TheArled/TheArled-s-KiCad-Library/3d_models/SLVS/Reference/251-Primo-EM158-6-mm-Omni-Electret-Capsules.png

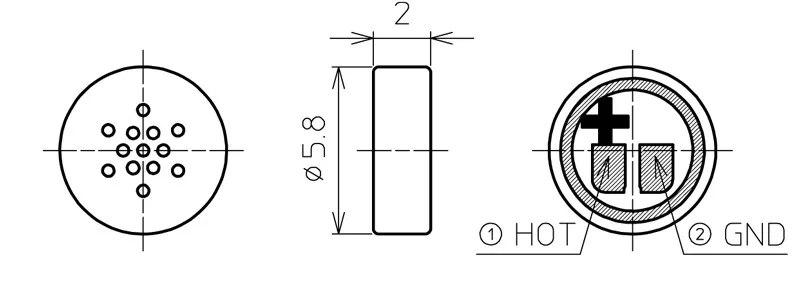
3d_models/SLVS/Reference/251-Primo-EM158-6-mm-Omni-Electret-Capsules.png
