TheArled/TheArled-s-KiCad-Library/3d_models/F305-1A7H1-21024-E100.step

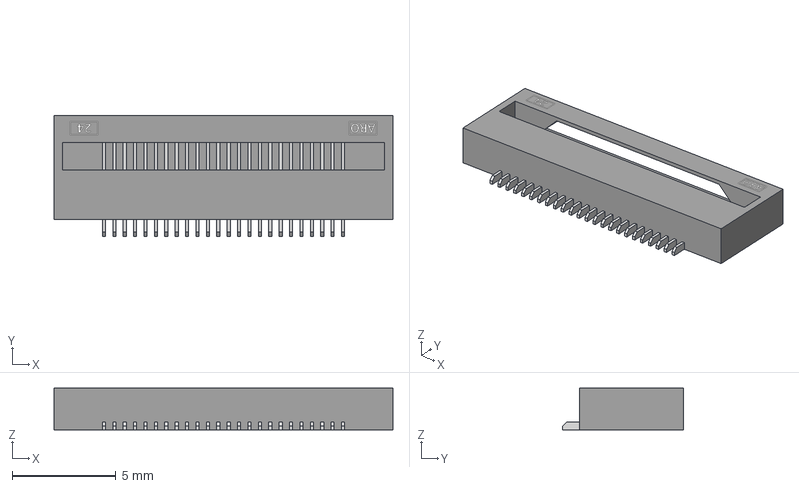
[picture p2: CAD file, 2025-11-04]
3d_models/F305-1A7H1-21024-E100.step
16.3 x 5.80 x 2.00 mm
