TheArled/TheArled-s-KiCad-Library/3d_models/MEM2075-00-140-01-A.step

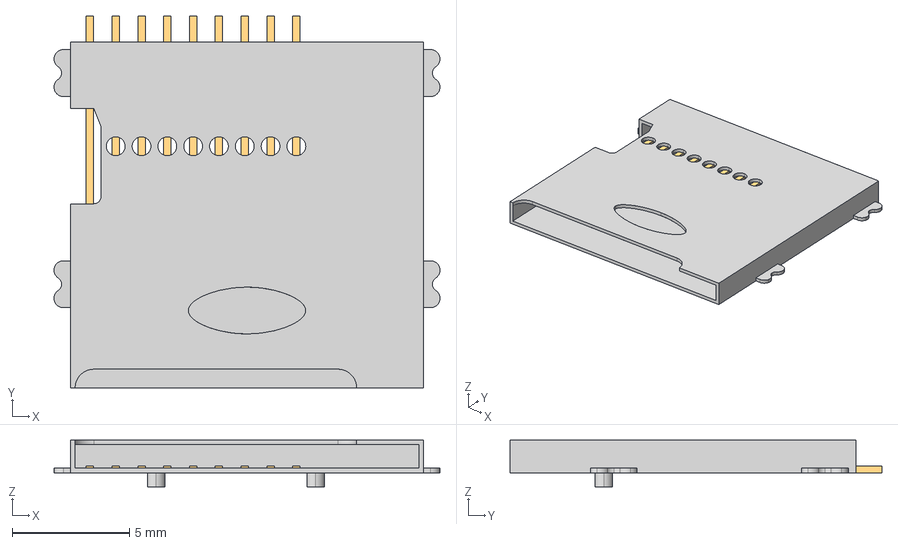
[picture p3: CAD file, 2025-11-04]
3d_models/MEM2075-00-140-01-A.step
16.4 x 15.8 x 2.00 mm
