TheArled/TheArled-s-KiCad-Library/3d_models/PEC16-2120F-S0012.step

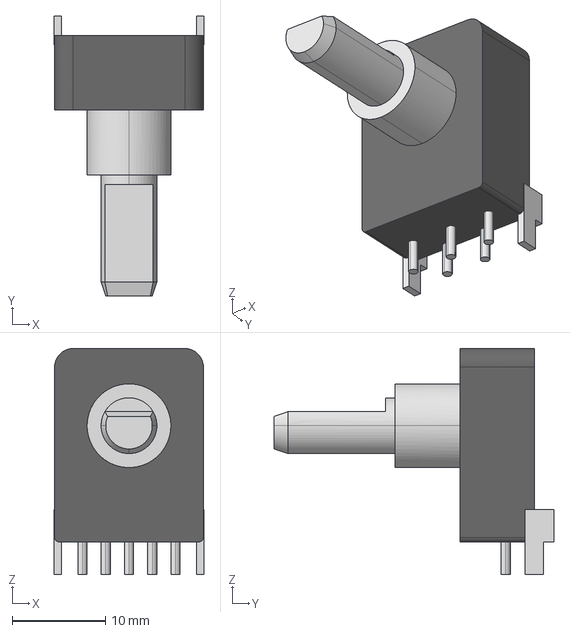
[picture p4: CAD file, 2025-11-04]
3d_models/PEC16-2120F-S0012.step
16.1 x 30.1 x 24.3 mm
