TheArled/TheArled-s-KiCad-Library/3d_models/A11AH.step

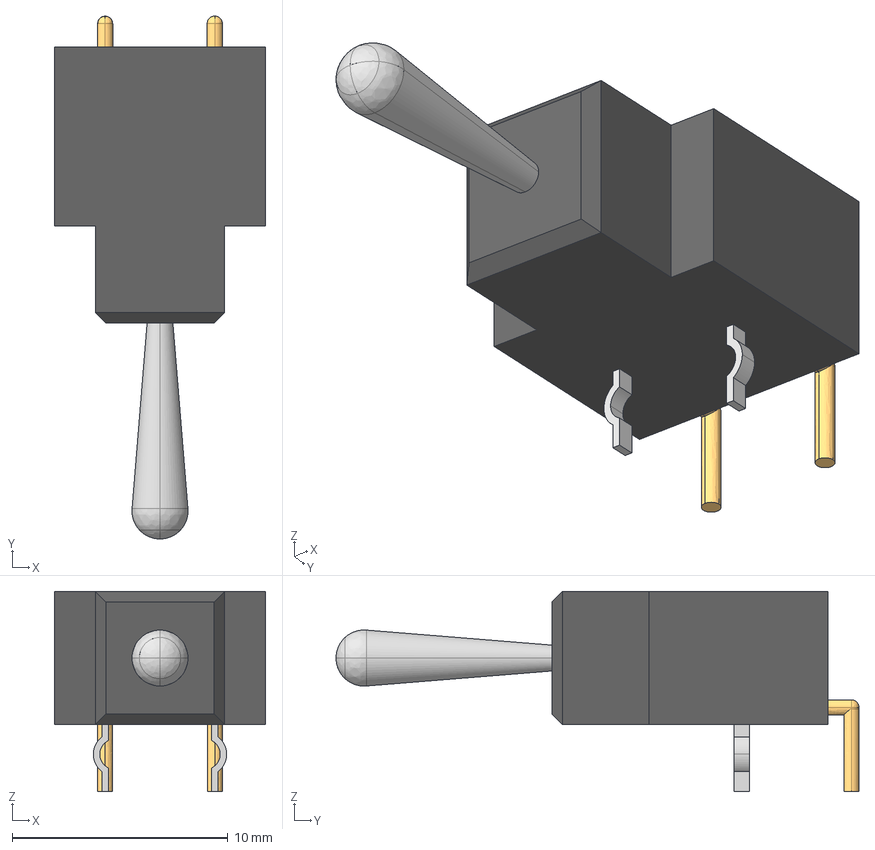
[picture p5: CAD file, 2025-11-03]
3d_models/A11AH.step
9.80 x 24.2 x 9.28 mm
