TheArled/TheArled-s-KiCad-Library/3d_models/53TR.step

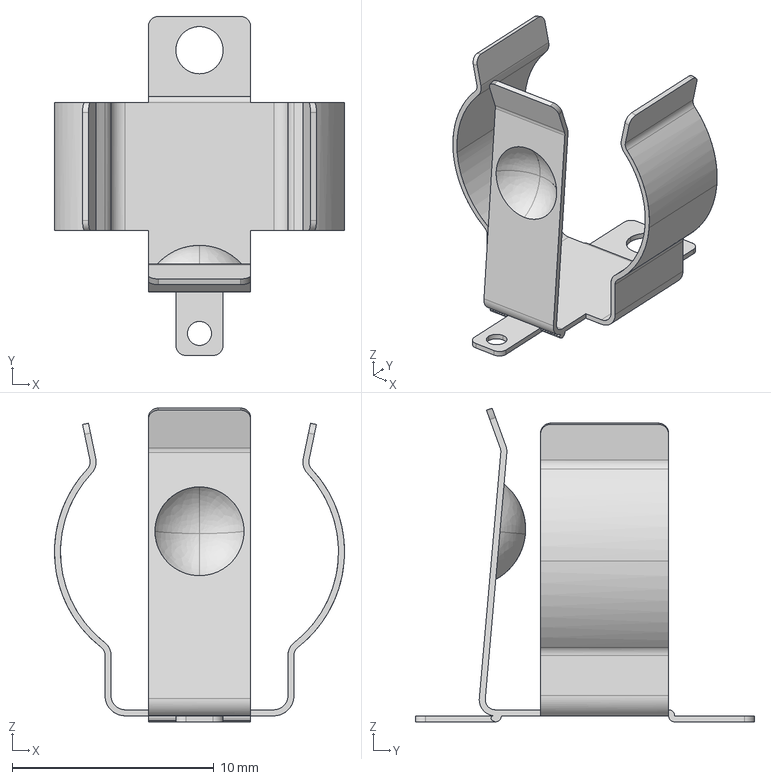
[picture p6: CAD file, 2025-10-24]
3d_models/53TR.step
14.4 x 16.8 x 15.6 mm
