TheArled/TheArled-s-KiCad-Library/3d_models/EM258.step

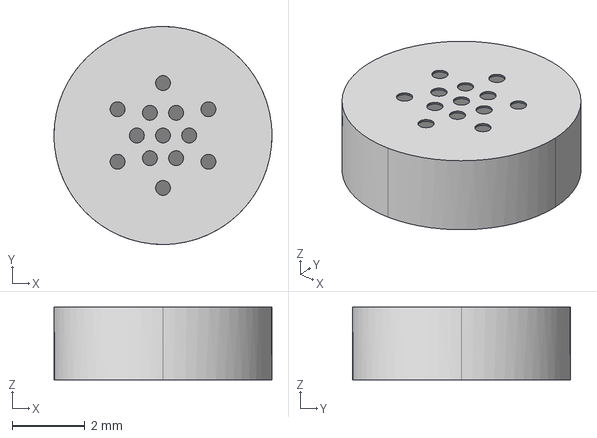
[picture p7: CAD file, 2025-10-20]
3d_models/EM258.step
6.00 x 6.00 x 2.00 mm
