TheArled/TheArled-s-KiCad-Library/3d_models/LTC3113EDHD#PBF.step

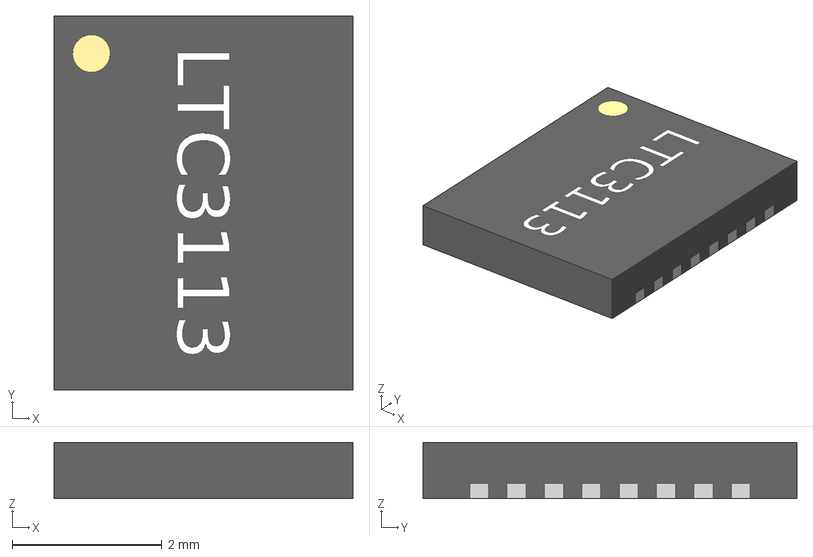
[picture p8: CAD file, 2025-09-15]
3d_models/LTC3113EDHD#PBF.step
4.00 x 5.00 x 0.75 mm
