TheArled/TheArled-s-KiCad-Library/3d_models/GRM188Z71A475ME15D.step

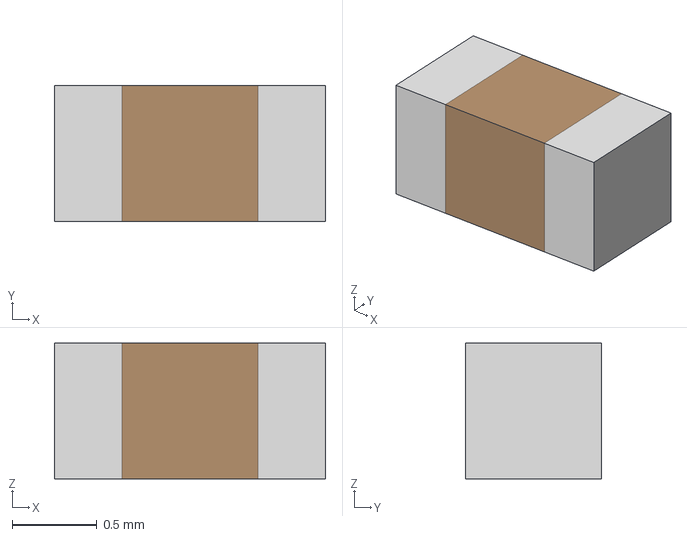
[picture p9: CAD file, 2025-09-12]
3d_models/GRM188Z71A475ME15D.step
1.60 x 0.8 x 0.8 mm
