TheArled/TheArled-s-KiCad-Library/3d_models/CX3225SA25000H0GSSC1.step

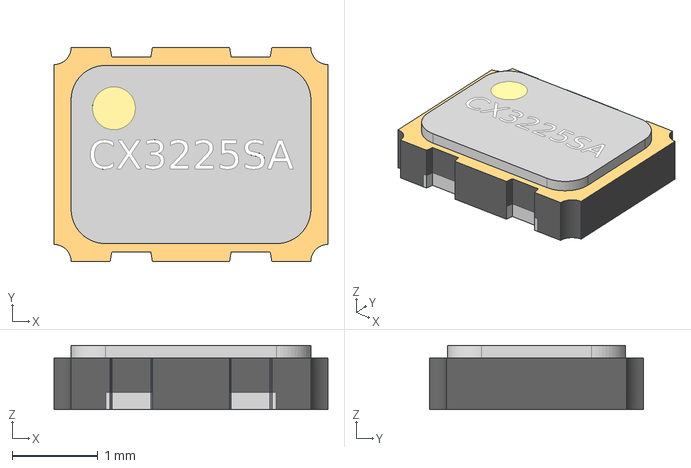
[picture p10: CAD file, 2025-09-12]
3d_models/CX3225SA25000H0GSSC1.step
3.20 x 2.50 x 0.75 mm
