TheArled/TheArled-s-KiCad-Library/3d_models/CDCE6214RGER.step

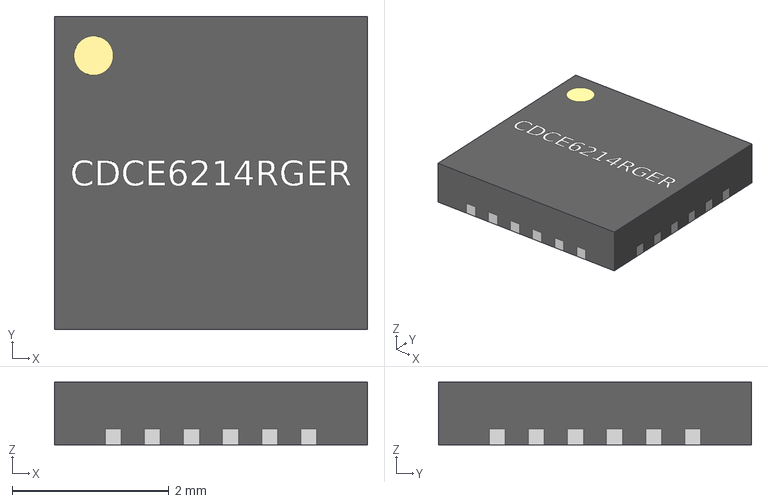
[picture p11: CAD file, 2025-09-12]
3d_models/CDCE6214RGER.step
4.00 x 4.00 x 0.8 mm
