TheArled/TheArled-s-KiCad-Library/3d_models/TPS7A2033PYCJR.step

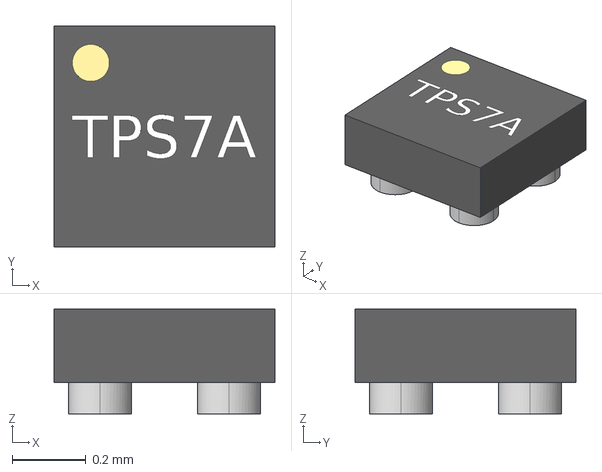
[picture p12: CAD file, 2025-09-09]
3d_models/TPS7A2033PYCJR.step
0.6 x 0.6 x 0.285 mm
