TheArled/TheArled-s-KiCad-Library/3d_models/PCM1820QRTERQ1.step

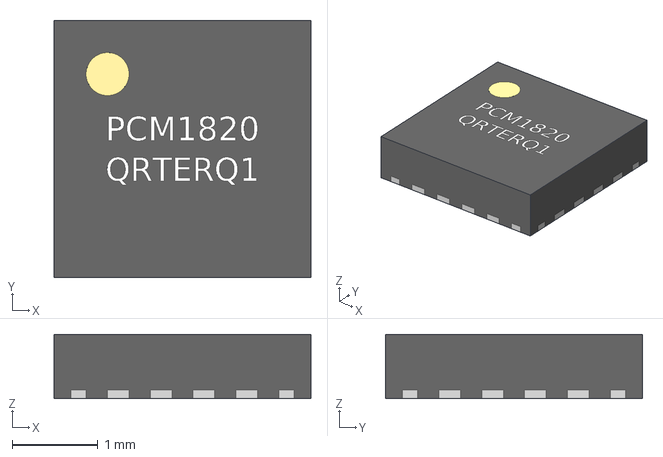
[picture p13: CAD file, 2025-09-09]
3d_models/PCM1820QRTERQ1.step
3.00 x 3.00 x 0.75 mm
