TheArled/TheArled-s-KiCad-Library/3d_models/TS472IQT.step

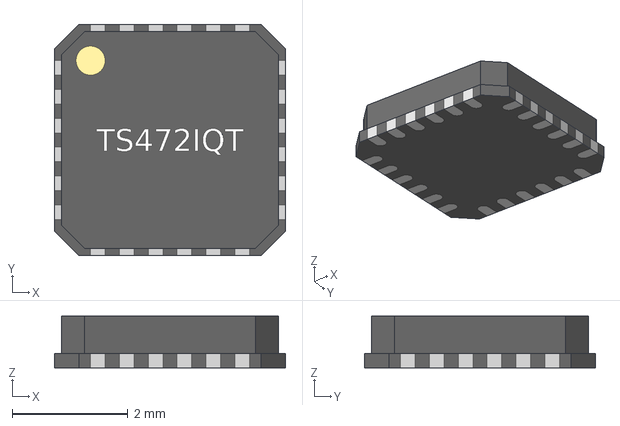
[picture p14: CAD file, 2025-09-09]
3d_models/TS472IQT.step
4.00 x 4.00 x 0.9 mm
