TheArled/TheArled-s-KiCad-Library/3d_models/2521020222501 (rev1).stp

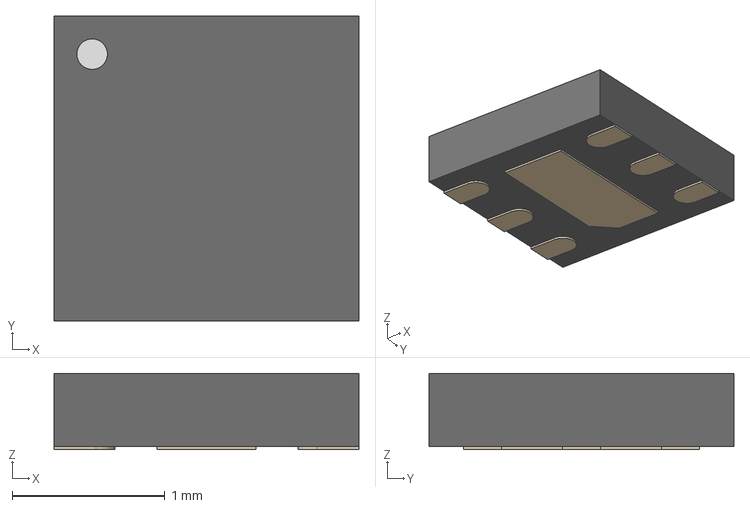
[picture p15: CAD file, 2025-10-28]
3d_models/2521020222501 (rev1).stp
2.00 x 2.00 x 0.5 mm
LandPads
Housing
