TheArled/TheArled-s-KiCad-Library/3d_models/76308-120LF.step

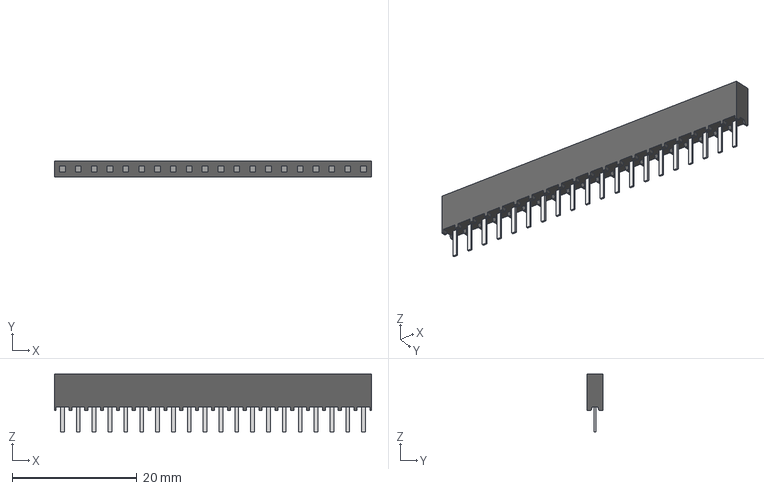
[picture p16: CAD file, 2025-10-20]
3d_models/76308-120LF.step
50.8 x 2.54 x 9.23 mm
