TheArled/TheArled-s-KiCad-Library/(list of files, cad)

Other CAD files:
3d_models/TPS7A2133BPYWDJ.step
3d_models/10129379-920002BLF.step
3d_models/5055750881.stp
3d_models/61200621621.step
3d_models/ACS37041.step
3d_models/TPS51601ADR.step
