TheArled/TheArled-s-KiCad-Library/documentations/00-9159-XXX-06X-XXXS.pdf

# RoHS

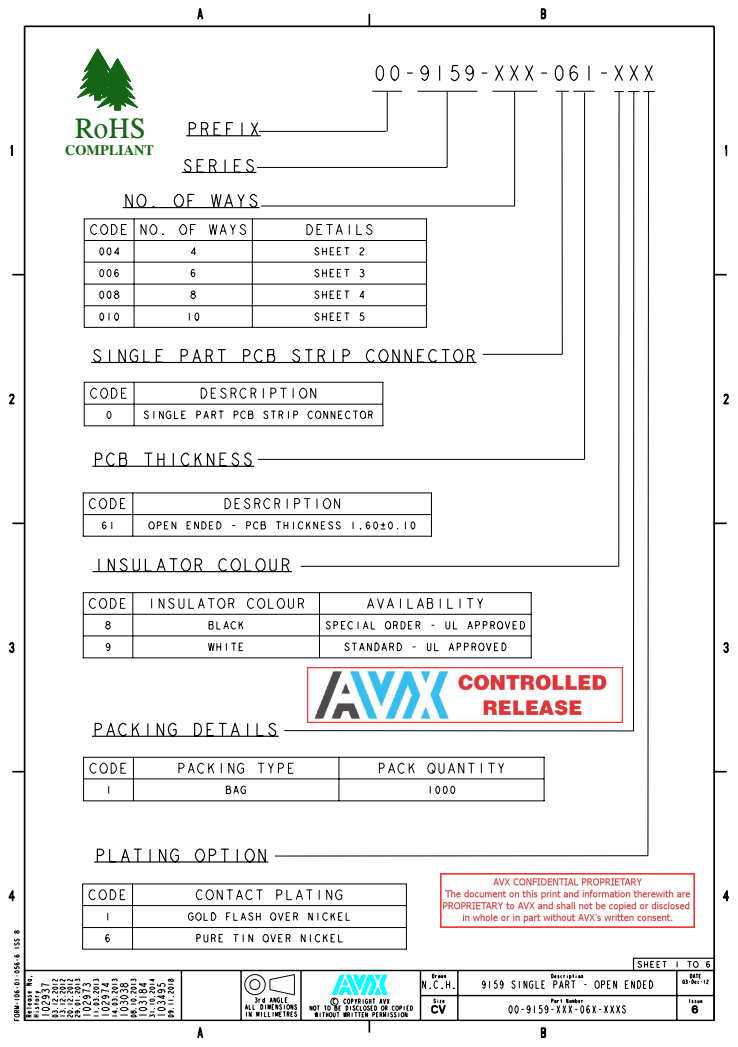
[picture p17: page 1]
COMPLIANT

# RoHS

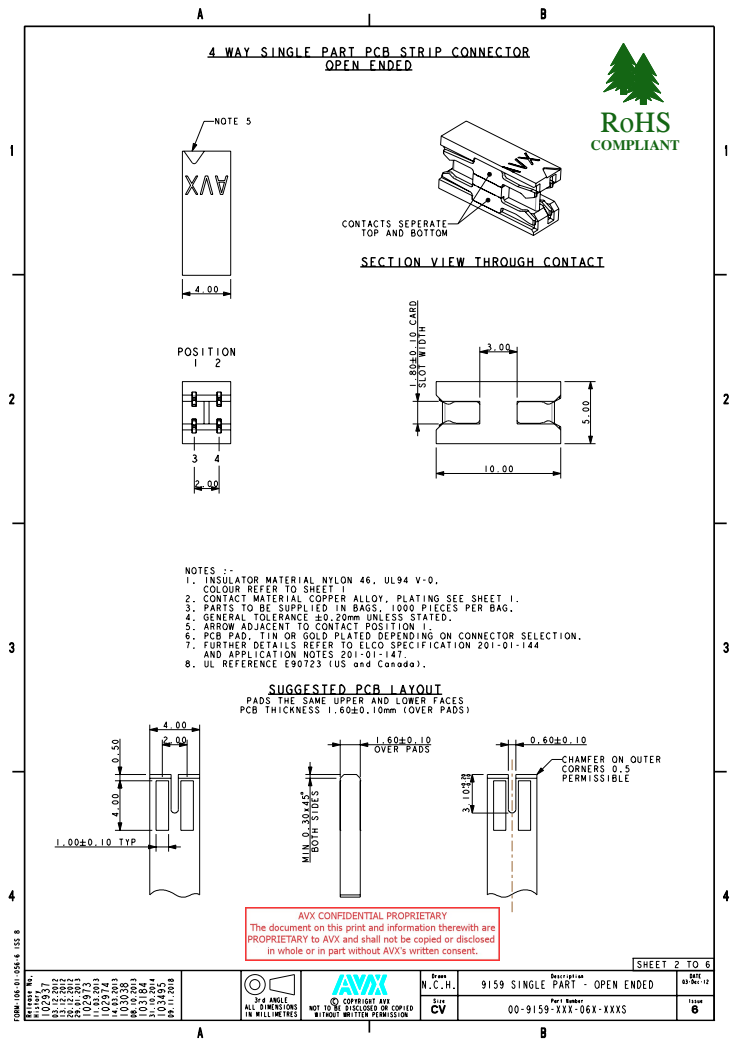
[picture p18: page 2]
COMPLIANT

# RoHS

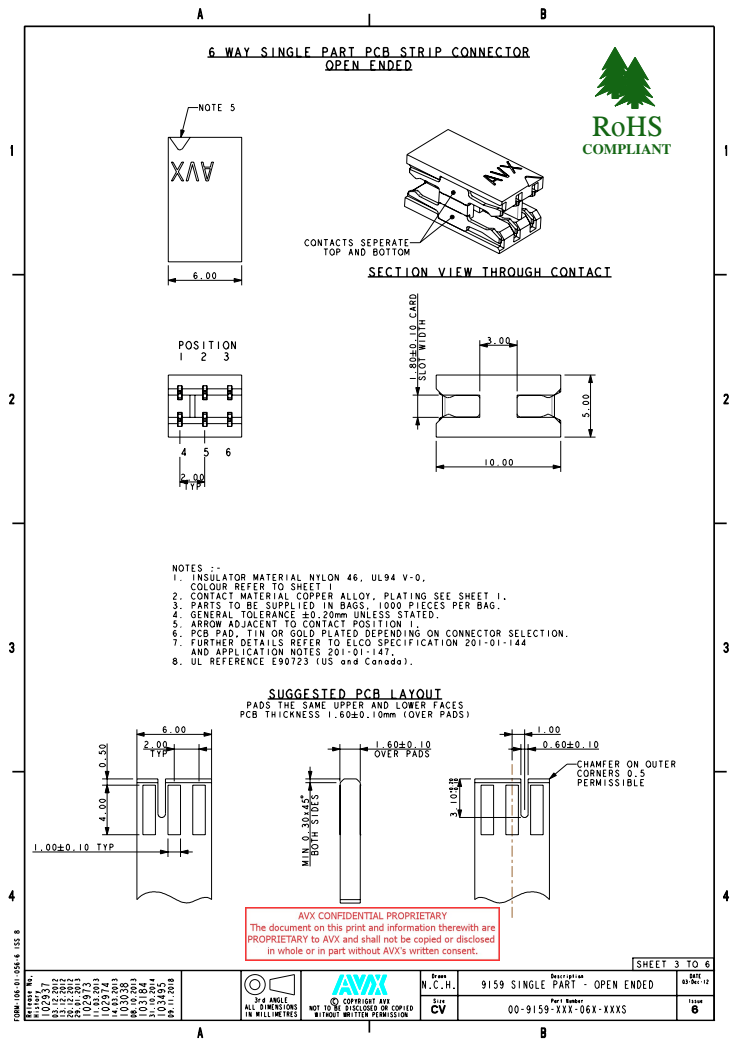
[picture p19: page 3]
COMPLIANT

# RoHS

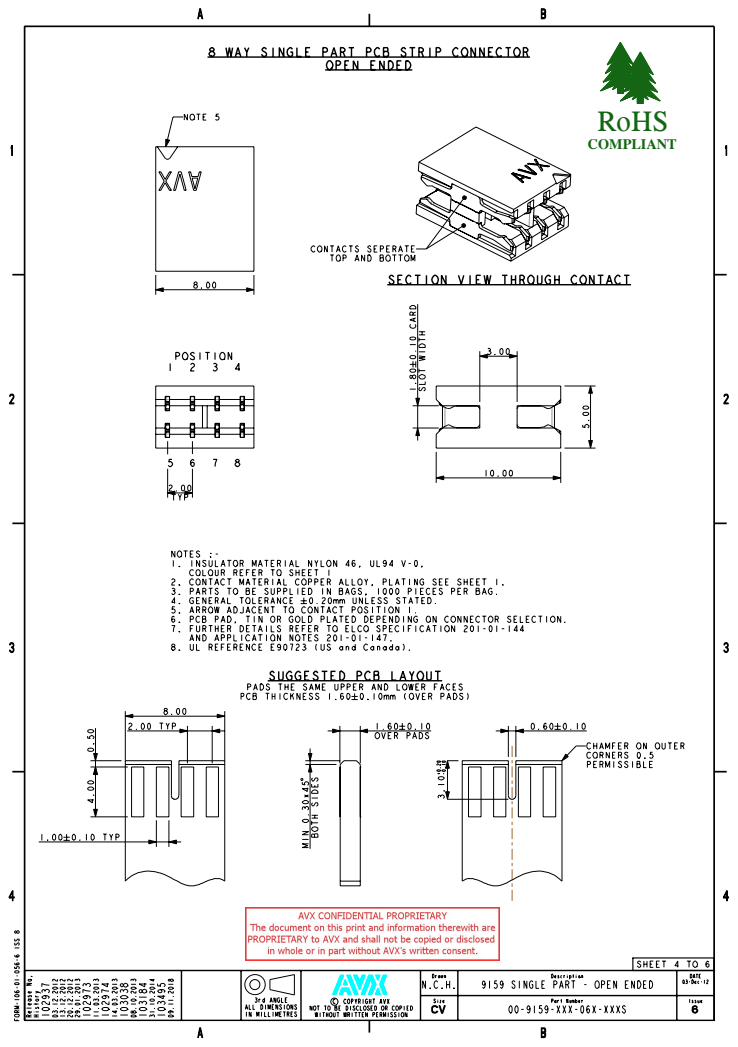
[picture p20: page 4]
COMPLIANT

# RoHS

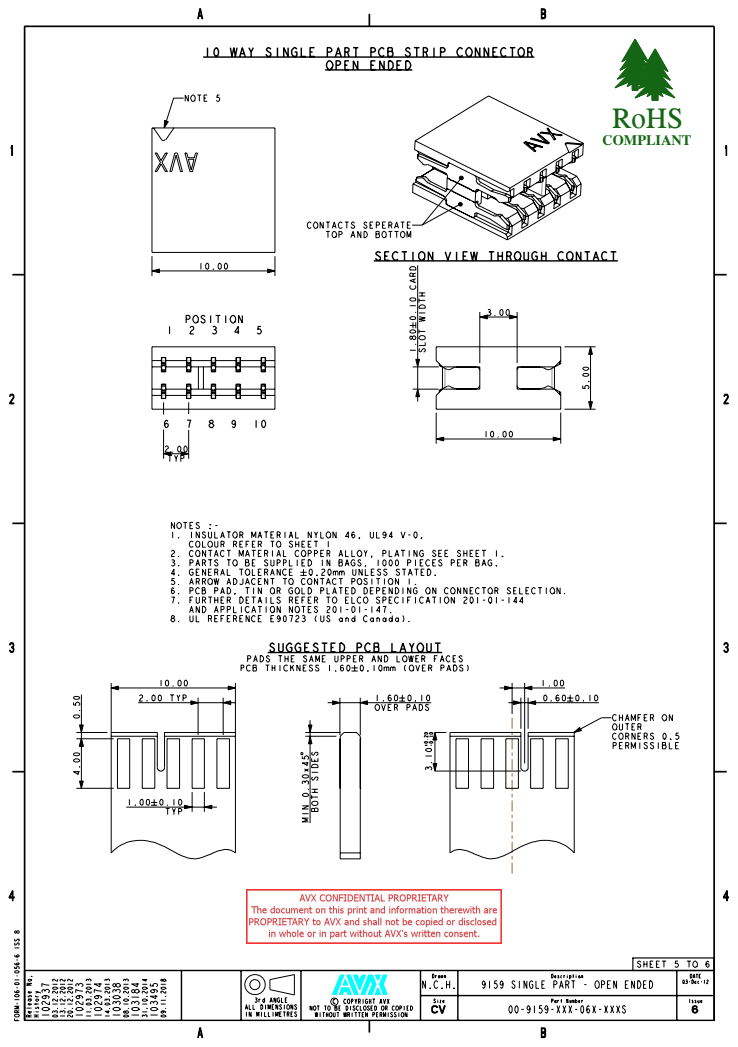
[picture p21: page 5]
COMPLIANT

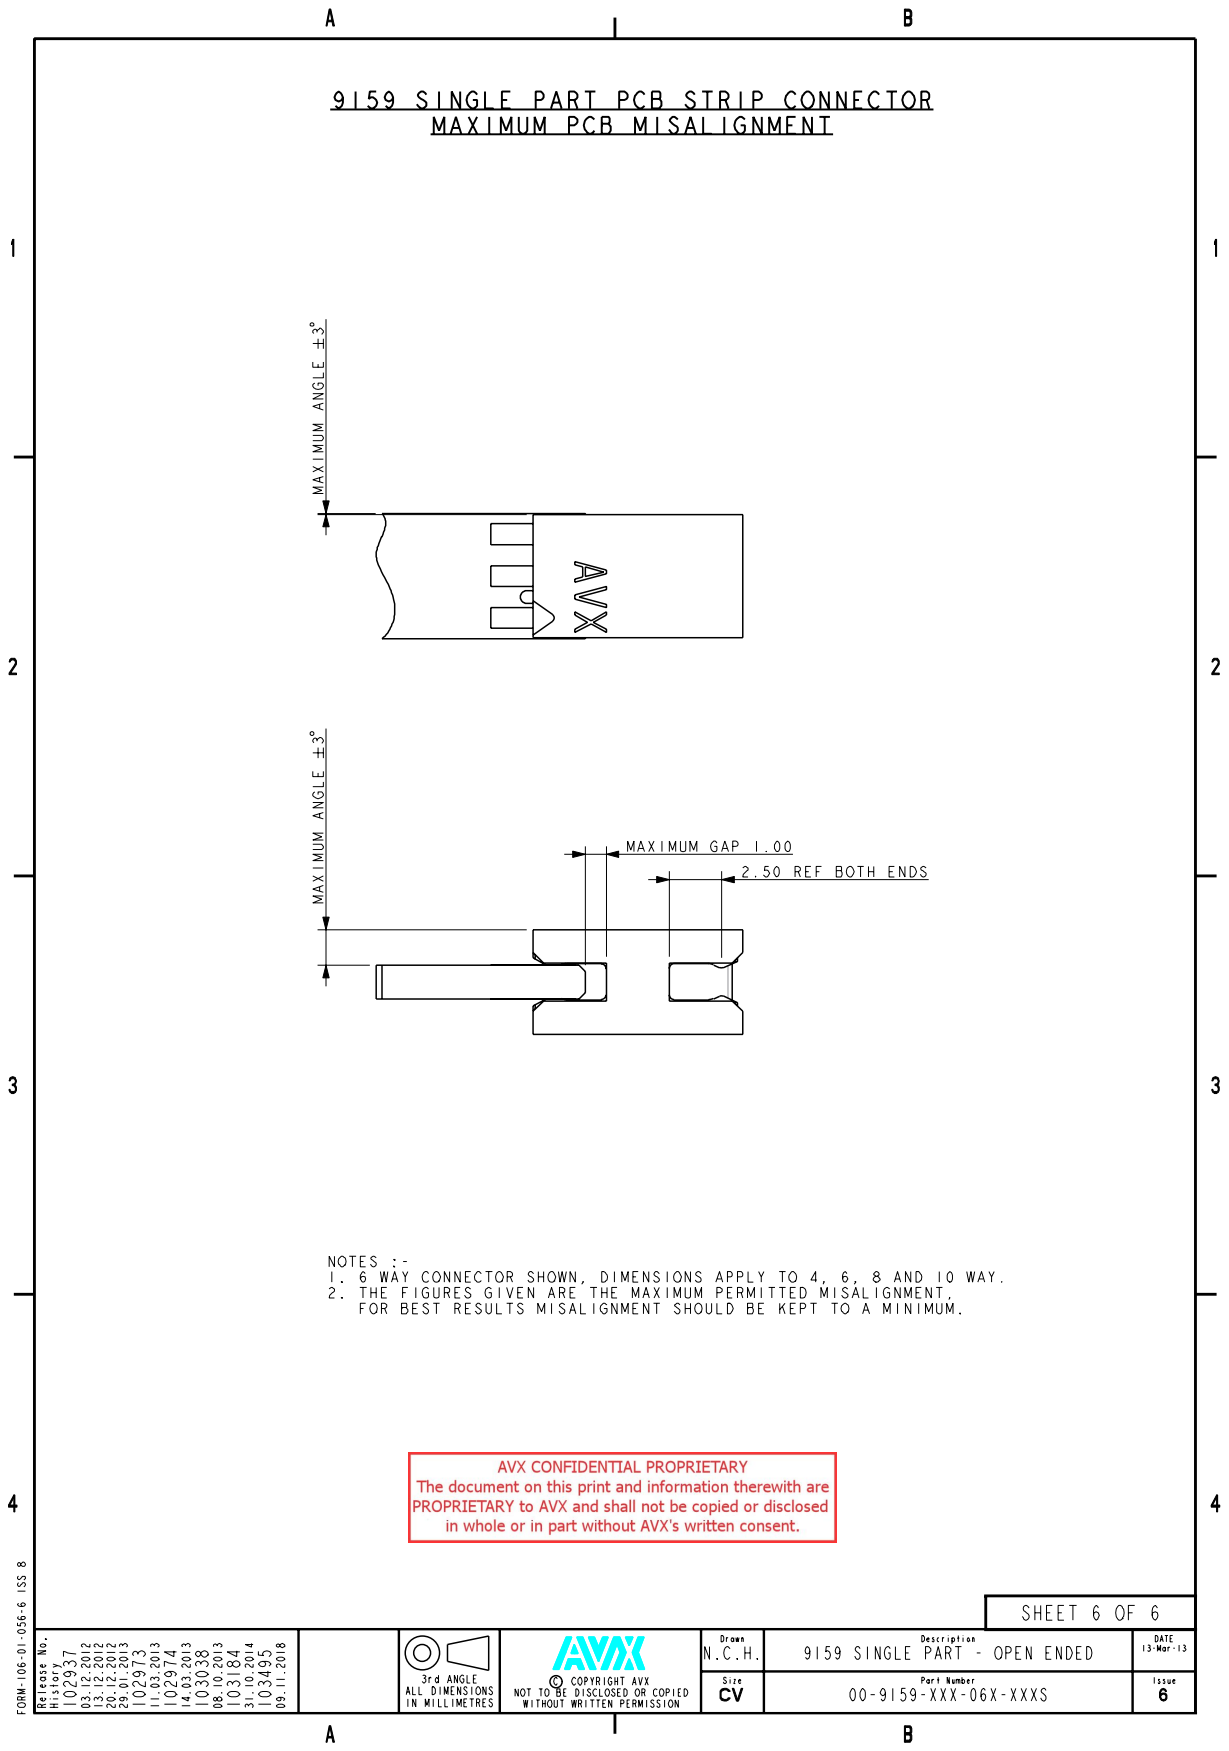
[picture p22: page 6]
