TheArled/TheArled-s-KiCad-Library/(commit log)

2025-09-09 Added STM TS472IQT
    [TS472IQT.step, TS472IQT.stl]
2025-09-09 Added some more detail to TS472IQT footprint
2025-09-09 Changed 3D model for dot to be more visible,even if it's less accurate to the original.
    [TS472IQT.step]
2025-09-09 Modified TS472IQT a bit, and added PCM1820QRTERQ1.
    [PCM1820QRTERQ1.step, TS472IQT.stl]
2025-09-09 Added new LDO's.
    [TPS7A2033PYCJR.step, TPS7A2133BPYWDJ.step]
2025-09-11 Added bead Murata Electronics BLM18AG121SN1D
    [BLM18AG121SN1D.step]
2025-09-12 Added some more components.
    [CDCE6214RGER.step, CX3225SA25000H0GSSC1.step, EM258.step, GRM188Z71A106MA73D.step, GRM188Z71A475ME15D.step]
2025-09-15 Added a few more devices.
    [LTC3113EDHD#PBF.step]
2025-09-23 Added a few more footprints and 3D models
    [ACS37041.step]
2025-09-24 More new footprints and stuff!
    [TPS51601ADR.step]
2025-10-17 Added molex connector
    [5055750881.stp]
2025-10-17 Added new footprint.
2025-10-20 Added new connector.
    [61200621621.step]
2025-10-20 Modified footprints
    [10129379-920002BLF.step, 76308-120LF.step]
2025-10-20 Added a better version of the PrimoMic, and made a footprint for it.
    [EM258.step]
2025-10-21 Added new footprints.
2025-10-24 Added some more footprints and 3D models.
    [53TR.step]
2025-10-28 Added wuerth thermistor
    [2521020222501 (rev1).stp]
2025-11-03 Added new libary.
    [A11AH.step]
2025-11-04 Added new footprints
    [PEC16-2120F-S0012.step]
2025-11-04 Added more 3D models.
    [F305-1A7H1-21024-E100.step, MEM2075-00-140-01-A.step]
